zlosynth/to-be-track-recorder/README.md

# Growing into a track recorder

# License

Software of this project is distributed under the terms of the General Public
License version 3. See [LICENSE-SOFTWARE](LICENSE-SOFTWARE) for details.

Schematics and PCB layout are distributed under the terms of Creative Commons
BY-SA. See [LICENSE-HARDWARE](LICENSE-HARDWARE) for details.

# Changelog

Read the [CHANGELOG.md](CHANGELOG.md) to learn about changes introduced in each
release.

# Versioning

See [VERSIONING.md](VERSIONING.md) to find detailed information about versioning
of the project and compatability between its software and hardware.
