zlosynth/to-be-track-recorder/CHANGELOG.md

# Changelog

All notable changes to this project will be documented in this file. See
[VERSIONING.md](VERSIONING.md) for more information about versioning and
backwards compatibility.

## Unreleased
