zlosynth/to-be-track-recorder/(commit log)

2023-09-09 Add a stub of KiCAD project
    [Module.kicad_pcb, Module.kicad_sch]
2023-09-10 Design the interface schematic and PCB
    [Module.kicad_pcb, Module.kicad_sch]
2023-09-10 Add cutouts for jack holes
    [Module.kicad_pcb]
2023-09-10 Fix LED component numbering on PCB
    [Module.kicad_pcb, Module.kicad_sch]
2023-09-10 Add standoff to PCB
    [Module.kicad_pcb]
2023-09-10 Add labels to describe footprints
    [Module.kicad_pcb]
2023-09-10 Fix trigger jack numbering
    [Module.kicad_pcb, Module.kicad_sch]
2023-09-10 Fix button footprint numbering
    [Module.kicad_pcb, Module.kicad_sch]
2023-09-15 Review and finalize schematic
    [Module.kicad_pcb, Module.kicad_sch]
2023-09-15 Address ERC warnings and errors
    [Module.kicad_sch]
2023-09-15 Use an available molex microSD conn
    [Module.kicad_pcb, Module.kicad_sch]
2023-09-16 Wire up PCB
    [Module.kicad_pcb, Module.kicad_sch]
2023-09-16 Resolve DRC PCB errors
    [Module.kicad_pcb]
2023-09-16 Align PCB back silkscreen labels
    [Module.kicad_pcb]
2023-09-16 Update part numbering based on PCB position
    [Module.kicad_pcb, Module.kicad_sch]
2023-09-16 Add page metadata to PCB
    [Module.kicad_pcb]
2023-09-16 Rotate power connector
    [Module.kicad_pcb]
2023-09-16 Add graphics to front silkscreen
    [Module.kicad_pcb]
2023-09-16 Add graphics to back silkscreen
    [Module.kicad_pcb]
2023-09-17 Fix DRC after some reorg
    [Module.kicad_pcb]
2023-09-26 Move license on PCB to the top
    [Module.kicad_pcb]
2023-09-26 Add points near pin 1s
    [Module.kicad_pcb]
2023-10-07 Add track representation
2023-10-08 Implement full flow of page management
2023-11-12 Align PCB labels
    [Module.kicad_pcb]
