zlosynth/to-be-track-recorder/(notices)

Notices in the files:
hardware/Module.kicad_sch:
CC BY-SA
hardware/Module.kicad_pcb:
Petr Horáček , 2023, CC BY-SA
